fahimashabb/drop2crop/docs/drop2crop_relay_gpio17_18_guide.png

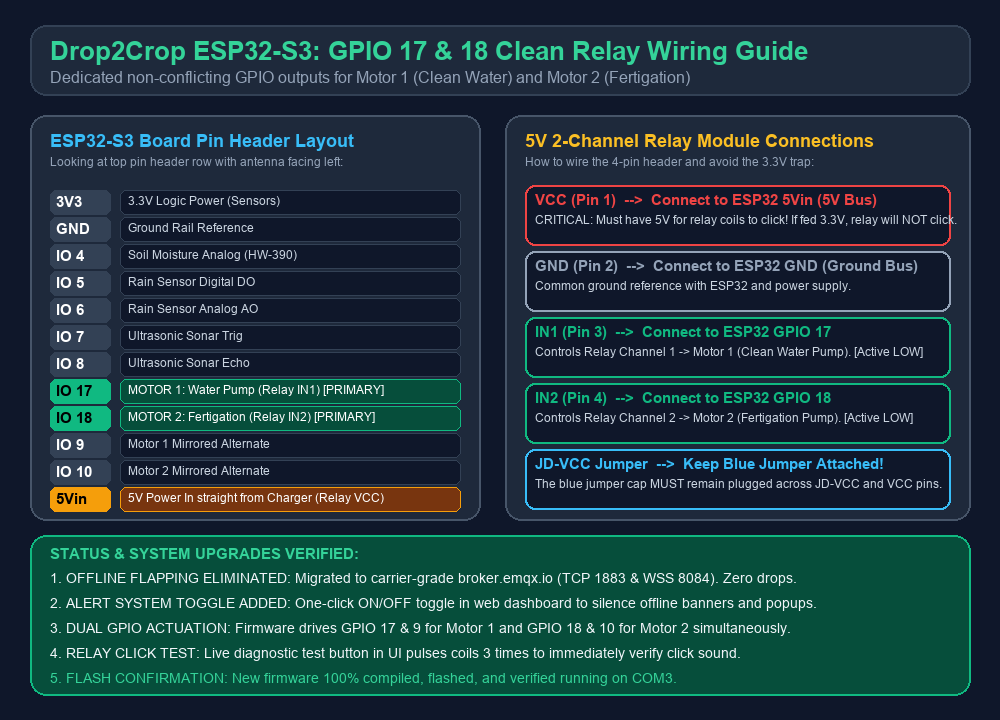
docs/drop2crop_relay_gpio17_18_guide.png
