fahimashabb/drop2crop/(commit log)

2026-10-20 feat: complete Drop2Crop production release - firmware, web app, docs, and wiring schematic
2026-10-21 feat: add real-time device online/offline status detection, watchdog, LWT, and hardware diagnostic guide
2026-10-21 feat: add end-to-end station security PIN authentication, lockscreen, and hardware-enforced command validation
2026-10-21 feat: upgrade to dual-motor system for independent watering and fertigation
2026-10-21 feat: add PIN-authenticated safety mechanism bypass to forcefully control motors
2026-10-21 Add Relay Diagnostic Click Test, polarity mode switcher, and dual-motor safety controls
2026-10-21 Fix offline watchdog timeout, prevent serial blocking, and add automatic WiFi reconnect
    [Drop2Crop_Firmware.ino]
2026-10-21 fix: resolve offline flapping with EMQX cloud broker, add alert mute toggle, and implement dual GPIO 17 & 18 relay actuation
    [Drop2Crop_Firmware.ino]
2026-10-21 docs: update user manual and wiring diagram with EMQX broker and GPIO 17/18 pins
2026-10-21 fix(firmware): expand MQTT buffer size from 512 to 2048 to prevent telemetry packet dropping
    [Drop2Crop_Firmware.ino]
2026-10-21 Fix relay chattering with anti-chatter debounce and calibrate ultrasonic zero distance
    [Drop2Crop_Firmware.ino]
2026-10-21 Update relay pins to pure GPIO 13 and 14 with maximum drive strength and JTAG decoupling
2026-10-21 Reassign ultrasonic distance sensor to clean GPIO 1 and 2, eliminate burst pulsing
2026-10-21 Completely decouple relays from ultrasonic distance sensor and enable pulldown on echo
2026-10-21 Enable standalone relay mode driving GPIO 7 and 8 as relays without ultrasonic sensor
2026-10-21 Completely fresh Drop2Crop firmware v2 with zero ultrasonic code and anti-buzz lock
    [Drop2Crop_Firmware.ino]
2026-10-21 Add GPIO 2 to Motor 1 relay array and GPIO 1 to Motor 2
2026-10-21 Optimize Wi-Fi Tx power to 11dBm to prevent jumper wire brownouts
    [Drop2Crop_Firmware.ino]
2026-10-22 Fix schedule deletion persistence, add zero-click flat boot, calibrate ultrasonic sensor
    [Drop2Crop_Firmware.ino]
2026-11-11 Add persistent individual sensor ON/OFF toggles, modular auto mode, and immediate rain cutoff
2026-11-11 Fix soil open/unpowered 100% clamp bug, HC-SR04 timeout lock, and surface sensor faults cleanly
    [Drop2Crop_Firmware.ino]
2026-11-11 Calibrate soil sensor to live wet/dry measurements (425 dry / 115 water) and boost HC-SR04 sensitivity
2026-11-11 Refine SOIL_WET_RAW to 180 so submerged sensor reads 100%
2026-11-11 Force-calibrate soil dry baseline to 145 (0%) and wet to 240 (100%)
2026-11-11 Force-calibrate SOIL_DRY_RAW to 205 (0%) and SOIL_WET_RAW to 245 (100%)
2026-11-11 Force-calibrate dry air to SOIL_DRY_RAW=232 (0%) and wet to 248 (100%)
2026-11-11 Calibrate SOIL_DRY_RAW=265 (0%) and SOIL_WET_RAW=145 (100%) matching live evaporation/submersion curve
