fahimashabb/drop2crop/(notices)

Notices in the files:
README.md:
License: MIT
